mpkendall/gumstik/hardware/Tiny4FSK.kicad_pcb

## KiCad design hardware/Tiny4FSK.kicad_pcb (2026-11-02)

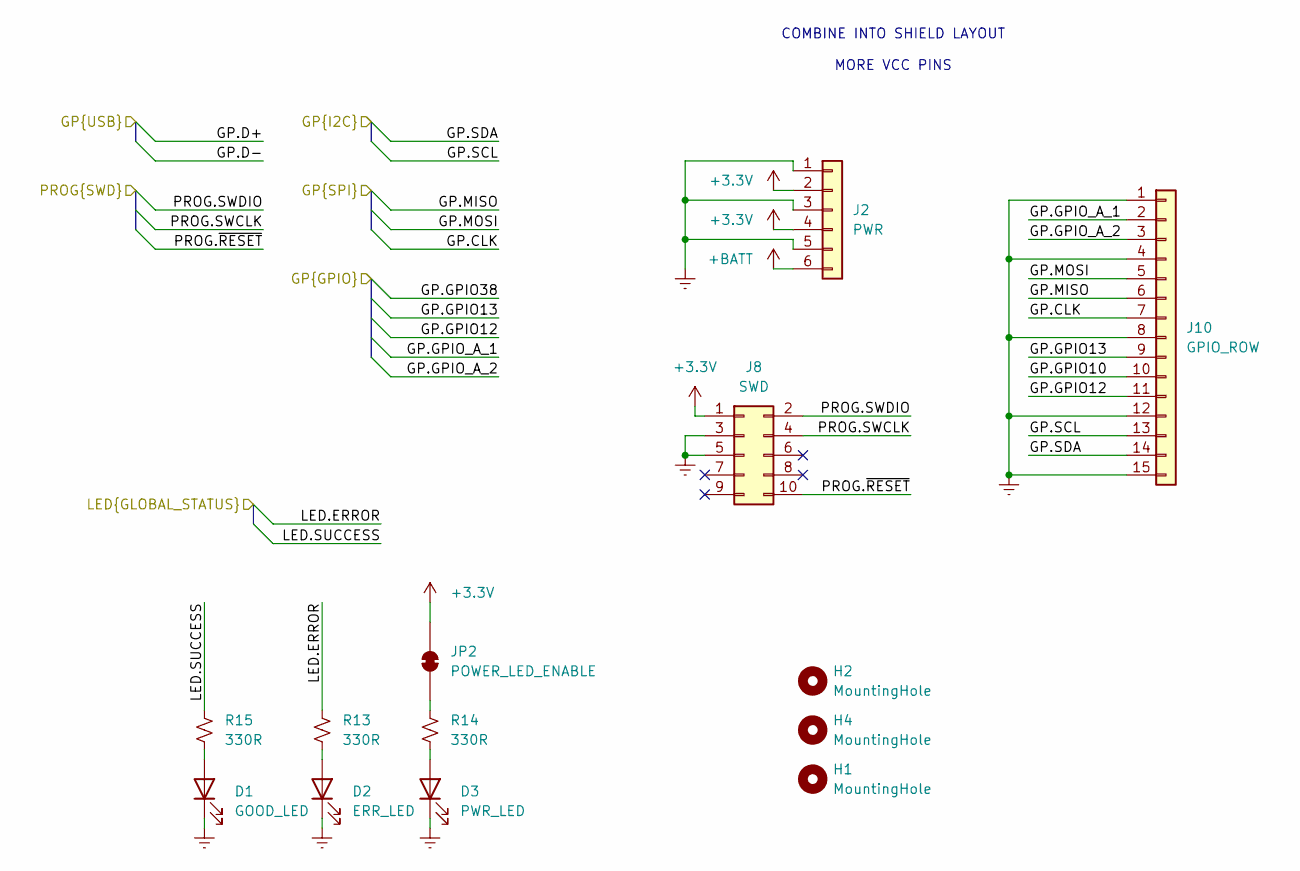
[picture p1: schematic interface.kicad_sch]

Parts:
D1: GOOD_LED; LED_0603_1608Metric; LCSC C2297
D2: ERR_LED; LED_0603_1608Metric; LCSC C84256
D3: PWR_LED; LED_0603_1608Metric; LCSC C84256
H1, H2, H4: MountingHole; MountingHole_2.2mm_M2
J2: PWR; PinHeader_1x06_P2.54mm_Vertical
J8: SWD; Pogo_2x05_P1.27mm
J10: GPIO_ROW; PinHeader_1x15_P2.54mm_Vertical
JP2: POWER_LED_ENABLE; SolderJumper-2_P1.3mm_Bridged_RoundedPad1.0x1.5mm
R13, R14, R15: 330R; C_0402_1005Metric; LCSC C23138

Connections:
+3.3V: J2.2, J2.4, J8.1, JP2.2 (B); also elsewhere on the board
+BATT: J2.6; also elsewhere on the board
/interface/GP.CLK: J10.7; also elsewhere on the board
/interface/GP.GPIO10: J10.10; also elsewhere on the board
/interface/GP.GPIO12: J10.11; also elsewhere on the board
/interface/GP.GPIO13: J10.9; also elsewhere on the board
/interface/GP.GPIO_A_1: J10.2; also elsewhere on the board
/interface/GP.GPIO_A_2: J10.3; also elsewhere on the board
/interface/GP.MISO: J10.6; also elsewhere on the board
/interface/GP.MOSI: J10.5; also elsewhere on the board
/interface/GP.SCL: J10.13; also elsewhere on the board
/interface/GP.SDA: J10.14; also elsewhere on the board
/interface/LED.ERROR: R13.1; also elsewhere on the board
/interface/LED.SUCCESS: R15.1; also elsewhere on the board
/interface/PROG.SWCLK: J8.4; also elsewhere on the board
/interface/PROG.SWDIO: J8.2; also elsewhere on the board
/interface/PROG.~RESET: J8.10; also elsewhere on the board
Earth: D1.1 (K), D2.1 (K), D3.1 (K), J2.1, J2.3, J2.5, J8.3, J8.5, J10.1, J10.4, J10.8, J10.12, J10.15; also elsewhere on the board
unnamed: D1.2 (A), R15.2
unnamed: D2.2 (A), R13.2
unnamed: D3.2 (A), R14.2
unnamed: JP2.1 (A), R14.1

Notes on the sheet:
COMBINE INTO SHIELD LAYOUT MORE VCC PINS

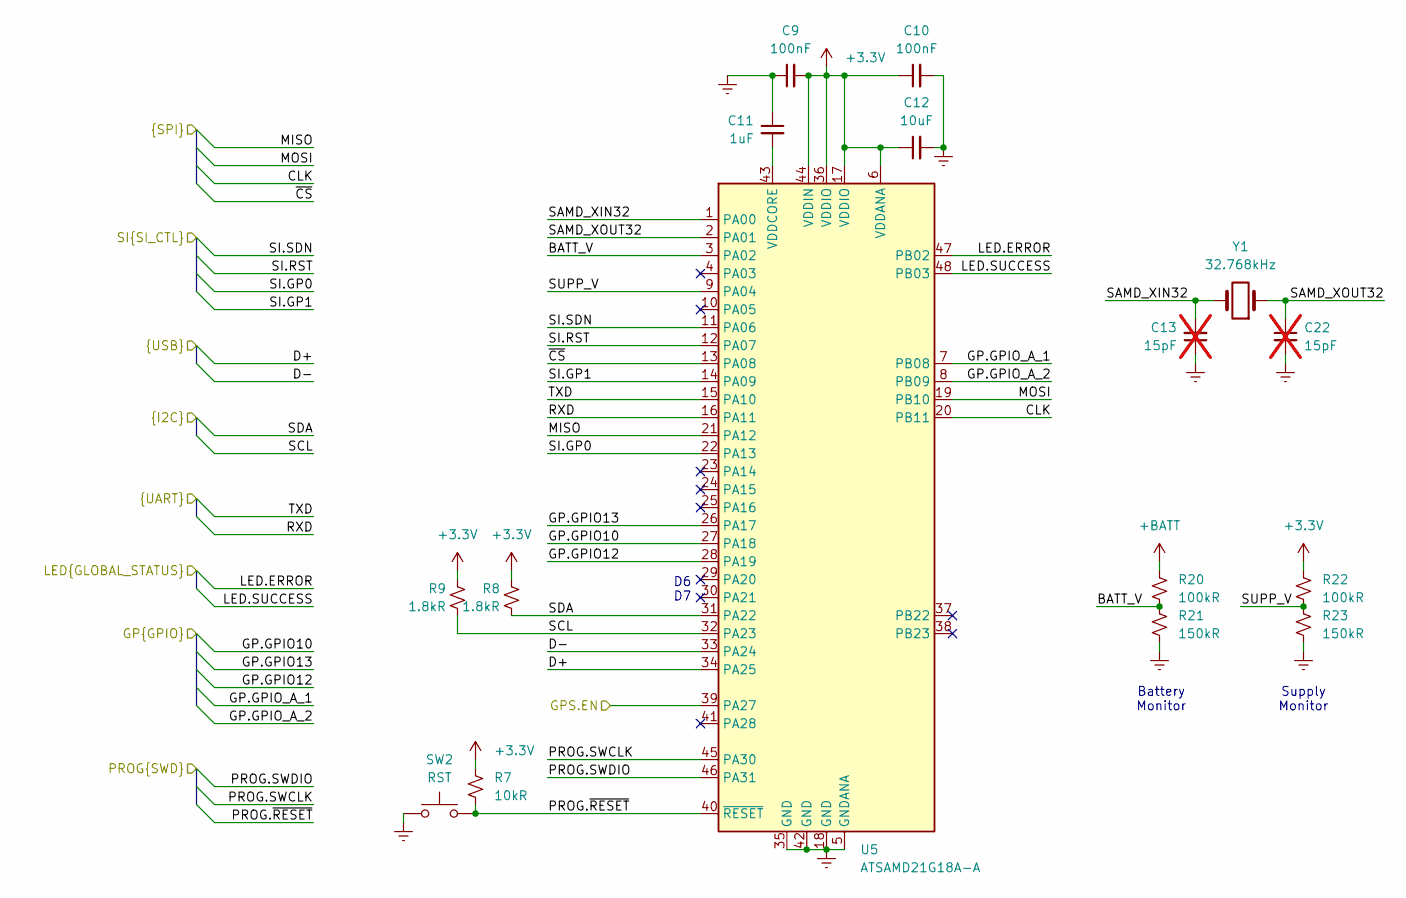
[picture p2: schematic mcu.kicad_sch]

Parts:
C9, C10: 100nF; C_0402_1005Metric; LCSC C1525
C11: 1uF; C_0402_1005Metric; LCSC C52923
C12: 10uF; C_0402_1005Metric; LCSC C19702
C13, C22: 15pF; C_0402_1005Metric; LCSC C1525; not fitted
R7: 10kR; R_0402_1005Metric; LCSC C25091
R8, R9: 1.8kR; R_0402_1005Metric; LCSC C4177
R20, R22: 100kR; C_0402_1005Metric; LCSC C26083
R21, R23: 150kR; C_0402_1005Metric; LCSC C26083
SW2: RST; SW_SPST_TS-1088-xR020; LCSC C2888954
U5: ATSAMD21G18A-A; TQFP-48_7x7mm_P0.5mm; LCSC C78624
Y1: 32.768kHz; Crystal_SMD_3215-2Pin_3.2x1.5mm; LCSC C32346

Connections:
+3.3V: C9.2, C10.1, C12.1, R7.2, R8.1, R9.1, R22.1, U5.6 (VDDANA), U5.17 (VDDIO), U5.36 (VDDIO), U5.44 (VDDIN); also elsewhere on the board
+BATT: R20.1; also elsewhere on the board
/interface/GP.CLK: U5.20 (PB11); also elsewhere on the board
/interface/GP.D+: U5.34 (PA25); also elsewhere on the board
/interface/GP.D-: U5.33 (PA24); also elsewhere on the board
/interface/GP.GPIO10: U5.27 (PA18); also elsewhere on the board
/interface/GP.GPIO12: U5.28 (PA19); also elsewhere on the board
/interface/GP.GPIO13: U5.26 (PA17); also elsewhere on the board
/interface/GP.GPIO_A_1: U5.7 (PB08); also elsewhere on the board
/interface/GP.GPIO_A_2: U5.8 (PB09); also elsewhere on the board
/interface/GP.MISO: U5.21 (PA12); also elsewhere on the board
/interface/GP.MOSI: U5.19 (PB10); also elsewhere on the board
/interface/GP.SCL: R9.2, U5.32 (PA23); also elsewhere on the board
/interface/GP.SDA: R8.2, U5.31 (PA22); also elsewhere on the board
/interface/GP.~CS: U5.13 (PA08); also elsewhere on the board
/interface/LED.ERROR: U5.47 (PB02); also elsewhere on the board
/interface/LED.SUCCESS: U5.48 (PB03); also elsewhere on the board
/interface/PROG.SWCLK: U5.45 (PA30); also elsewhere on the board
/interface/PROG.SWDIO: U5.46 (PA31); also elsewhere on the board
/interface/PROG.~RESET: R7.1, SW2.2, U5.40 (~RESET); also elsewhere on the board
/mcu/BATT_V: R20.2, R21.1, U5.3 (PA02)
/mcu/GPS.EN: U5.39 (PA27); also elsewhere on the board
/mcu/RXD: U5.16 (PA11); also elsewhere on the board
/mcu/SAMD_XIN32: C13.2, U5.1 (PA00), Y1.2
/mcu/SAMD_XOUT32: C22.1, U5.2 (PA01), Y1.1
/mcu/SI.GP0: U5.22 (PA13); also elsewhere on the board
/mcu/SI.GP1: U5.14 (PA09); also elsewhere on the board
/mcu/SI.RST: U5.12 (PA07); also elsewhere on the board
/mcu/SI.SDN: U5.11 (PA06); also elsewhere on the board
/mcu/SUPP_V: R22.2, R23.1, U5.9 (PA04)
/mcu/TXD: U5.15 (PA10); also elsewhere on the board
Earth: C9.1, C10.2, C11.1, C12.2, C13.1, C22.2, R21.2, R23.2, SW2.1, U5.5 (GNDANA), U5.18 (GND), U5.35 (GND), U5.42 (GND); also elsewhere on the board
unnamed: C11.2, U5.43 (VDDCORE)

Notes on the sheet:
Battery Monitor
Supply Monitor
D6 D7

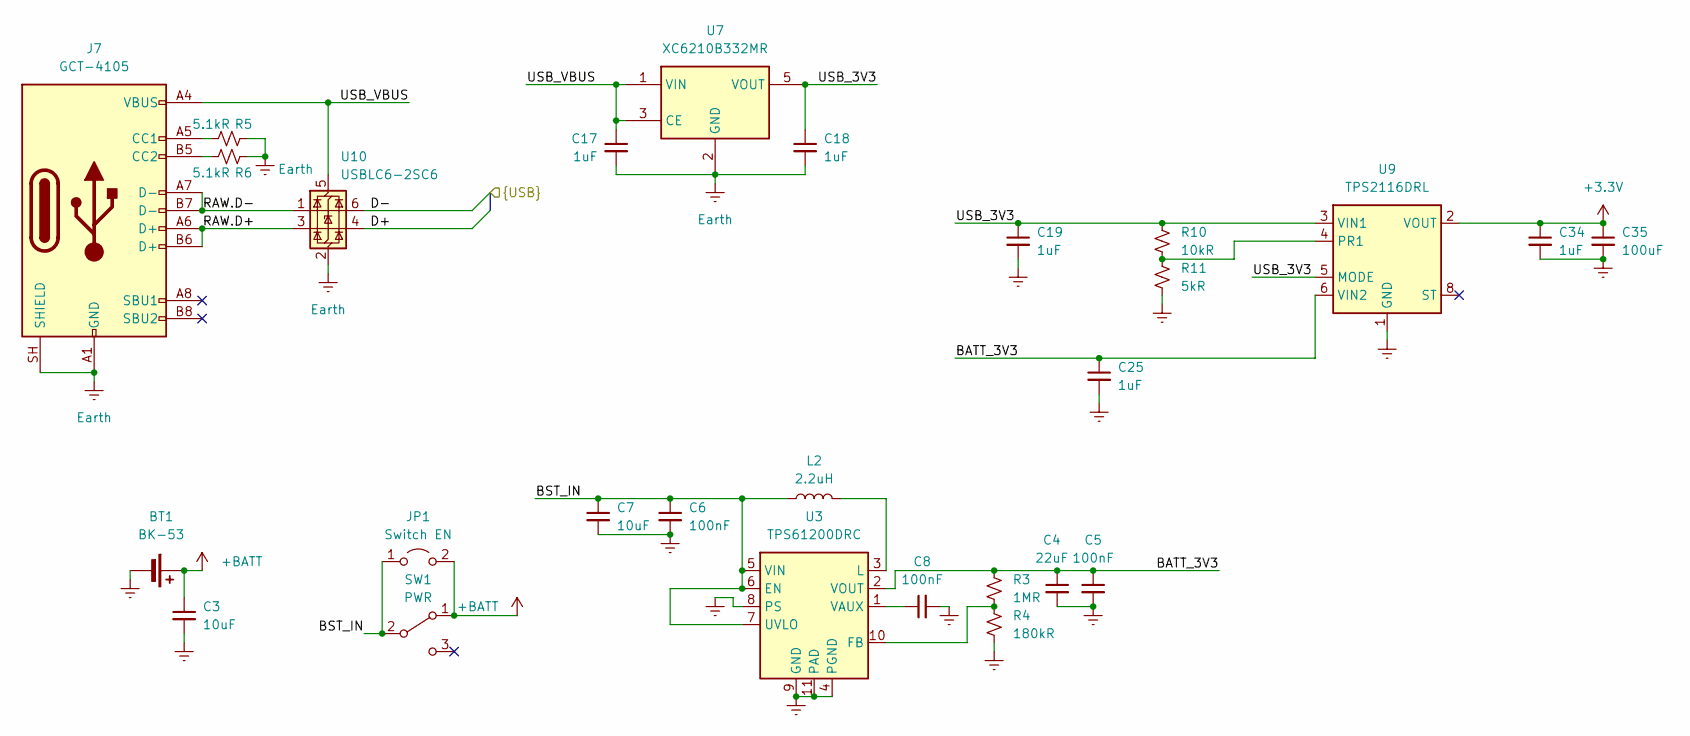
[picture p3: schematic power.kicad_sch]

Parts:
BT1: BK-53; BAT_BK-53
C3: 10uF; C_0402_1005Metric; LCSC C52923
C4: 22uF; C_0402_1005Metric; LCSC C59461
C5, C6, C8: 100nF; C_0402_1005Metric; LCSC C1525
C7: 10uF; C_0402_1005Metric; LCSC C19702
C17, C18, C19, C25, C34: 1uF; C_0402_1005Metric; LCSC C52923
C35: 100uF; C_0402_1005Metric; LCSC C52923
J7: GCT-4105; USB_C_Receptacle_GCT_USB4105-xx-A_16P_TopMnt_Horizontal; LCSC C2760486
JP1: Switch EN; SolderJumper-2_P1.3mm_Open_Pad1.0x1.5mm
L2: 2.2uH; L_Coilcraft_LPS3010; LCSC C2844756
R3: 1MR; R_0402_1005Metric; LCSC C26083
R4: 180kR; R_0402_1005Metric; LCSC C100276
R5, R6: 5.1kR; R_0402_1005Metric; LCSC C25905
R10: 10kR; R_0402_1005Metric
R11: 5kR; R_0402_1005Metric
SW1: PWR; SW_SPDT_PCM12; LCSC C963206
U3: TPS61200DRC; Texas_S-PVSON-N10_ThermalVias
U7: XC6210B332MR; SOT-23-5; LCSC C3021084
U9: TPS2116DRL; SOT-583-8; LCSC C3235557
U10: USBLC6-2SC6; SOT-23-6; LCSC C7519

Connections:
+3.3V: C34.1, C35.1, U9.2 (VOUT), U9.7 (VOUT); also elsewhere on the board
+BATT: BT1.1 (+), C3.1, JP1.2 (B), SW1.1 (A); also elsewhere on the board
/interface/GP.D+: U10.4 (I/O2); also elsewhere on the board
/interface/GP.D-: U10.6 (I/O1); also elsewhere on the board
/power/BATT_3V3: C4.1, C5.1, C25.1, R3.1, U3.2 (VOUT), U9.6 (VIN2)
/power/BST_IN: C6.1, C7.1, JP1.1 (A), L2.2, SW1.2 (B), U3.5 (VIN), U3.6 (EN), U3.7 (UVLO)
/power/RAW.D+: J7.A6 (D+), J7.B6 (D+), U10.3 (I/O2)
/power/RAW.D-: J7.A7 (D-), J7.B7 (D-), U10.1 (I/O1)
/power/USB_3V3: C18.1, C19.1, R10.2, U7.5 (VOUT), U9.3 (VIN1), U9.5 (MODE)
/power/USB_VBUS: C17.1, J7.A4 (VBUS), J7.A9 (VBUS), J7.B4 (VBUS), J7.B9 (VBUS), U7.1 (VIN), U7.3 (CE), U10.5 (VBUS)
Earth: BT1.2 (-), C3.2, C4.2, C5.2, C6.2, C7.2, C8.2, C17.2, C18.2, C19.2, C25.2, C34.2, C35.2, J7.A1 (GND), J7.A12 (GND), J7.B1 (GND), J7.B12 (GND), J7.SH (SHIELD), R4.2, R5.2, R6.2, R11.1, U3.4 (PGND), U3.8 (PS), U3.9 (GND), U3.11 (PAD), U7.2 (GND), U9.1 (GND), U10.2 (GND); also elsewhere on the board
unnamed: J7.A5 (CC1), R5.1
unnamed: J7.B5 (CC2), R6.1
unnamed: R3.2, R4.1, U3.10 (FB)
unnamed: L2.1, U3.3 (L)
unnamed: C8.1, U3.1 (VAUX)
unnamed: R10.1, R11.2, U9.4 (PR1)

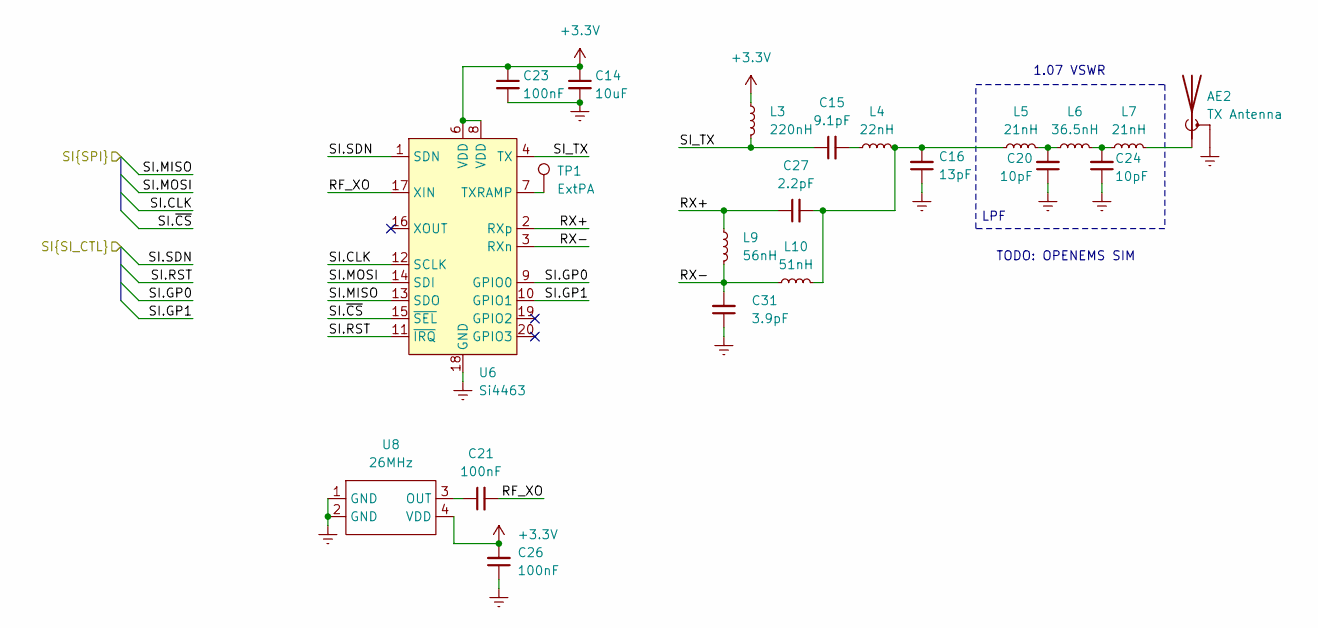
[picture p4: schematic radio.kicad_sch]

Parts:
AE2: TX Antenna; SMA_Samtec_SMA-J-P-H-ST-EM1_EdgeMount
C14: 10uF; C_0402_1005Metric; LCSC C19702
C15: 9.1pF; C_0402_1005Metric
C16: 13pF; C_0402_1005Metric
C20, C24: 10pF; C_0402_1005Metric
C21: 100nF; C_0402_1005Metric
C23, C26: 100nF; C_0402_1005Metric; LCSC C1525
C27: 2.2pF; C_0402_1005Metric
C31: 3.9pF; C_0402_1005Metric
L3: 220nH; L_0402_1005Metric
L4: 22nH; L_0402_1005Metric
L5, L7: 21nH; L_0402_1005Metric
L6: 36.5nH; L_0402_1005Metric
L9: 56nH; L_0402_1005Metric
L10: 51nH; L_0402_1005Metric
TP1: ExtPA; TestPoint_Pad_D1.0mm
U6: Si4463; QFN-20-1EP_4x4mm_P0.5mm_EP2.6x2.6mm_ThermalVias; LCSC C476202
U8: 26MHz; Crystal_SMD_2016-4Pin_2.0x1.6mm; LCSC C135223

Connections:
+3.3V: C14.1, C23.1, C26.2, L3.1, U6.6 (VDD), U6.8 (VDD), U8.4 (VDD); also elsewhere on the board
/interface/GP.CLK: U6.12 (SCLK); also elsewhere on the board
/interface/GP.MISO: U6.13 (SDO); also elsewhere on the board
/interface/GP.MOSI: U6.14 (SDI); also elsewhere on the board
/interface/GP.~CS: U6.15 (~SEL); also elsewhere on the board
/mcu/SI.GP0: U6.9 (GPIO0); also elsewhere on the board
/mcu/SI.GP1: U6.10 (GPIO1); also elsewhere on the board
/mcu/SI.RST: U6.11 (~IRQ); also elsewhere on the board
/mcu/SI.SDN: U6.1 (SDN); also elsewhere on the board
/radio/RF_XO: C21.2, U6.17 (XIN)
/radio/RX+: C27.1, L9.1, U6.2 (RXp)
/radio/RX-: C31.2, L9.2, L10.1, U6.3 (RXn)
/radio/SI_TX: C15.1, L3.2, U6.4 (TX)
Earth: AE2.2 (Shield), C14.2, C16.1, C20.1, C23.2, C24.1, C26.1, C31.1, U6.18 (GND), U6.21 (GND), U8.1 (GND), U8.2 (GND); also elsewhere on the board
unnamed: AE2.1 (RF), L7.2
unnamed: C15.2, L4.1
unnamed: C16.2, C27.2, L4.2, L5.1, L10.2
unnamed: C20.2, L5.2, L6.1
unnamed: C24.2, L6.2, L7.1
unnamed: TP1.1 (1_1), U6.7 (TXRAMP)
unnamed: C21.1, U8.3 (OUT)

Notes on the sheet:
1.07 VSWR
TODO: OPENEMS SIM
LPF

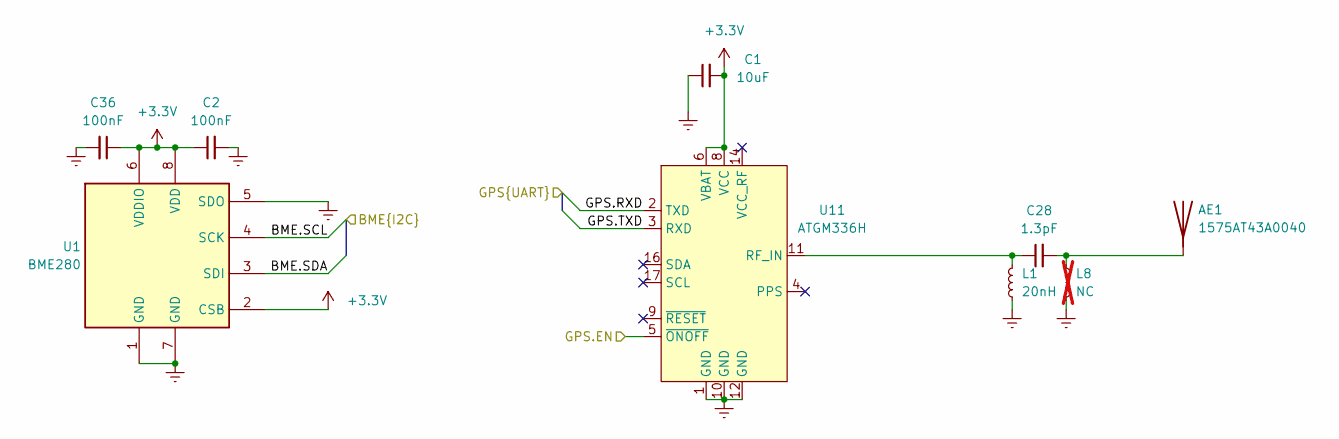
[picture p5: schematic sensors.kicad_sch]

Parts:
AE1: 1575AT43A0040; ANT_1575AT_JOT; LCSC C239243
C1: 10uF; C_0402_1005Metric; LCSC C19702
C2, C36: 100nF; C_0402_1005Metric; LCSC C52923
C28: 1.3pF; C_0402_1005Metric; LCSC C1525
L1: 20nH; C_0402_1005Metric; LCSC C307609
L8: NC; L_0402_1005Metric; LCSC C307609; not fitted
U1: BME280; Bosch_LGA-8_2.5x2.5mm_P0.65mm_ClockwisePinNumbering; LCSC C92489
U11: ATGM336H; ublox_MAX; LCSC C5117921

Connections:
+3.3V: C1.2, C2.1, C36.1, U1.2 (CSB), U1.6 (VDDIO), U1.8 (VDD), U11.6 (VBAT), U11.8 (VCC); also elsewhere on the board
/interface/GP.SCL: U1.4 (SCK); also elsewhere on the board
/interface/GP.SDA: U1.3 (SDI); also elsewhere on the board
/mcu/GPS.EN: U11.5 (~ONOFF); also elsewhere on the board
/mcu/RXD: U11.2 (TXD); also elsewhere on the board
/mcu/TXD: U11.3 (RXD); also elsewhere on the board
Earth: C1.1, C2.2, C36.2, L1.1, L8.2, U1.1 (GND), U1.5 (SDO), U1.7 (GND), U11.1 (GND), U11.10 (GND), U11.12 (GND); also elsewhere on the board
unnamed: AE1.1 (A_1), C28.2, L8.1
unnamed: C28.1, L1.2, U11.11 (RF_IN)

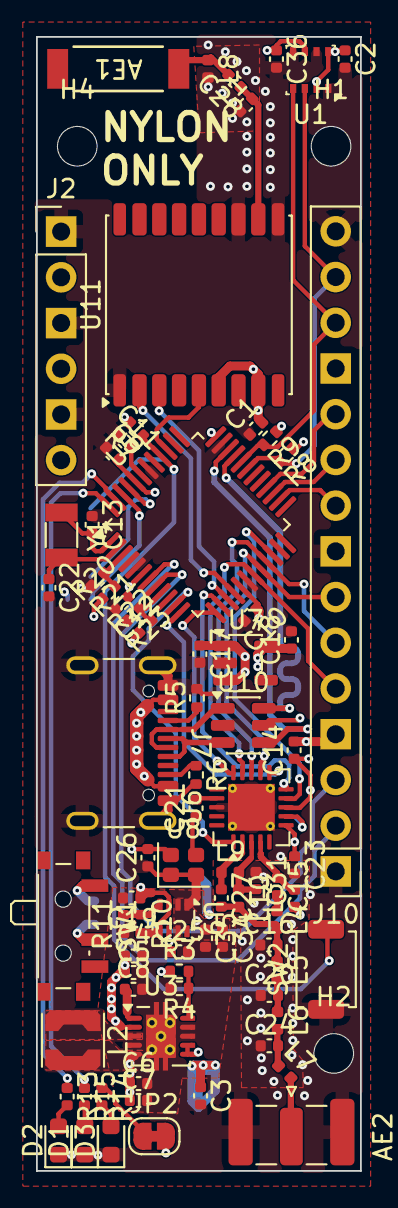
[picture p6: board Tiny4FSK.kicad_pcb from above]

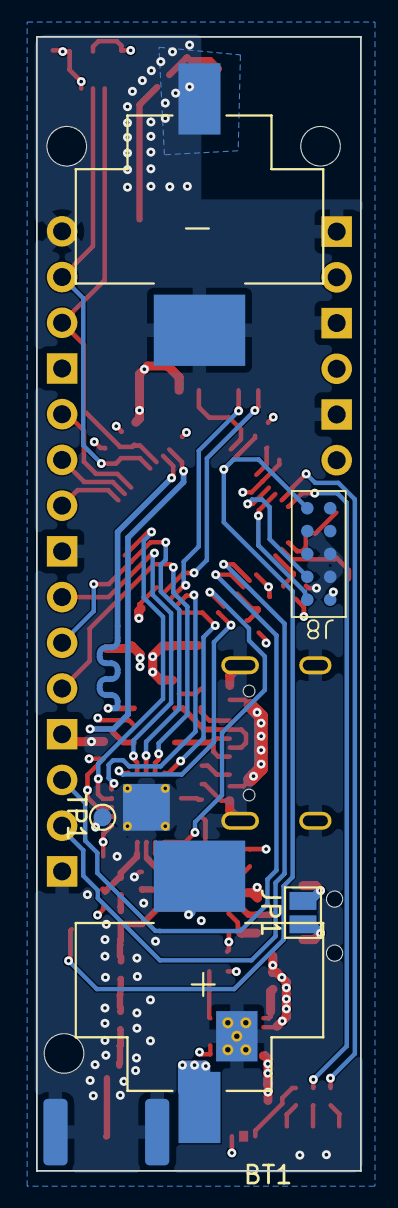
[picture p7: board Tiny4FSK.kicad_pcb from below]

Board: 4 copper layers, 18.0 x 63.0 mm, 86 parts (4 on the bottom side), 62 nets.
